hyc6equj5/Instrumental-method-of-particle-physics/README.md

# Instrumental-method-of-particle-physics
This page is for the final project of the course and related codes uploaded!
